Ahad-04/Agriculture-4.0-Seamless-Data-Integration-in-Agricultural-Supply-Chains-ASC-via-IoT-Technologies/NFC/report.docx

Report on NFC-Based Low-Power Sensor Data Reading System

1. Introduction / Background

In our project, we use an MCU (Arduino UNO or Mega) connected with multiple sensors, MQ-2, MQ-4, and DHT22 along with a microSD card module.
The system periodically measures sensor values (every 10 minutes) and stores them in a CSV file on the SD card for data logging and later analysis.

However, continuous wireless transmission using Bluetooth or Wi-Fi modules was found to be power-hungry, making them unsuitable for battery-powered or energy-harvesting systems (like solar or electromagnetic recovery setups).
To achieve ultra-low-power real-time data access, we adopted an NFC-based communication interface using the PN532 NFC Module V3.

This module operates at 13.56 MHz (per ISO/IEC 14443 A/B standards) and supports NFC peer-to-peer, card emulation, and reader modes.
It enables reading of latest sensor values directly from the MCU memory without requiring continuous high-power wireless connectivity.

2. Power Efficiency Motivation

According to the PN532 module datasheet (NXP Semiconductors, 2021):

Parameter | Typical Value | Description / Reference
Operating voltage | 3.3 – 5 V | Compatible with Arduino UNO/Mega logic levels
Operating current (active read mode) | < 100 mA @ 5 V | Active RF field during data transmission
Standby current (RF field on) | 10 µA | Ultra-low standby consumption
Frequency | 13.56 MHz | ISO/IEC 14443 A/B and FeliCa compliant carrier
Communication interface | I²C / SPI / UART | Selectable by DIP switch on V3 board

In comparison:

- Bluetooth (HC-05 / HM-10): 25–40 mA continuous active current
- Wi-Fi (ESP8266 / ESP32): 70–170 mA transmit current peaks
- NFC (PN532): < 100 mA only during tag read, then drops to < 10 µA idle

Hence, NFC reduces average current draw when data access is infrequent (once per few minutes), making it ideal for low-duty-cycle environmental sensor nodes powered by small batteries or energy harvesters.

3. Overview of NFC Technology

3.1 Principle of Operation

Near-Field Communication (NFC) is a short-range (≤ 10 cm) wireless technology standardized under ISO/IEC 18092 and ECMA-340.
It operates at 13.56 MHz, enabling bidirectional data exchange between:

- a Reader/Writer (Initiator)
- and a Tag/Target (Responder).

NFC supports three operation modes:

1. Reader/Writer Mode, Reads/writes passive tags (Type A/B/FeliCa).
2. Peer-to-Peer (P2P) Mode, Two NFC devices exchange data (Active ↔ Passive).
3. Card Emulation Mode, NFC device behaves like a contactless smart card.

Typical data rates: 106 kbps – 424 kbps, with modulation via amplitude-shift keying (ASK).

Reference: PN532 Datasheet

4. PN532 V3 Module – Description and Features

4.1 Hardware Overview

The PN532 V3 module integrates NXP’s PN532 transceiver IC, an RF antenna, and level-shifting logic for Arduino compatibility.
It exposes SPI, I²C, and UART interfaces selectable by onboard DIP switches.

Key specs from the datasheet:

Feature | Description
Chipset | NXP PN532 (ISO/IEC 14443 A/B, 18092)
Frequency | 13.56 MHz ± 7 kHz
Interface | UART / I²C / SPI selectable
Voltage | 3.3 – 5 V tolerant
Current | 60 mA active RF, < 10 µA standby
Range | Up to 5 cm (depends on antenna & field strength)

The module’s onboard DIP switch configures the interface:

- SW1 = ON, SW2 = OFF → UART
- SW1 = OFF, SW2 = ON → I²C
- SW1 = OFF, SW2 = OFF → SPI

5. Implementation for Sensor Data Access

5.1 System Architecture

- Sensors → analog/digital inputs to MCU.
- Arduino logs readings to datalog.csv on the SD card every 10 min.
- PN532 connects via SPI/I²C to the same MCU.
- Smartphone or another NFC device reads the latest value from Arduino memory when tapped.

5.2 Method 1: Using a Single NFC Module and NFC-Enabled Mobile Phone

Concept:
The PN532 operates in Card Emulation Mode (Target mode).
The Arduino continuously updates a small NDEF message containing the latest reading.
When a phone is brought near the module, it reads this message as an NFC tag.

Data Flow:

1. MCU measures sensors and stores readings:
2. Example readings: Temp=27.3°C, Hum=51%, MQ2=143 ppm, MQ4=210 ppm
3. MCU formats this as an NDEF Text record.
4. PN532 stores and advertises the NDEF data in emulation mode.
5. Phone’s NFC reader energizes the field → reads the NDEF payload.
6. Android/iOS automatically shows the message.

Advantages:

- No pairing, no app required.
- Ultra-low power (RF only active during tap).
- Secure short-range (≤ 5 cm).

5.3 Method 2: Two NFC Modules (P2P Communication Between MCUs)

Concept:
Use one PN532 as Initiator (Reader/Controller) and another as Target (Sensor Node).
This leverages the Peer-to-Peer Mode defined by NFCIP-1 (ISO/IEC 18092).

Hardware Setup:

- Node A (Sensor Unit): Arduino + Sensors + PN532 (Target)
- Node B (Receiver Unit): Another MCU + PN532 (Initiator)

Process:

1. Sensor Node periodically prepares the latest readings.
2. When Receiver Node comes near (within 5 cm), it establishes an NFC P2P link.
3. The Initiator requests data using “DEP (Data Exchange Protocol)” frames.
4. The Target sends back formatted sensor readings (text or binary).
5. Receiver displays data on Serial Monitor or LCD.

Advantages:

- Works without smartphones.
- Secure, device-to-device exchange.
- Moderate range (≤ 5 cm).
- Data integrity via CRC16 (per ISO 14443 frame).

5.4 Method 3: Using PN532 as Reader to Poll Passive Tag

In alternate mode, the PN532 acts as a Reader, and a programmable NFC tag (MIFARE Ultralight/NTAG) can store recent readings.
Arduino can update tag memory via I²C at each interval; phone can read tag directly later.
This decouples power domains: the tag remains readable even if MCU is off.

5.5 If Mobile Phone Does Not Support NFC

- Option 1: Use another MCU + PN532 as Initiator (Method 2).
- Option 2: Employ a BLE module (HM-10) temporarily for diagnostics.
- Option 3: Retrieve logs manually via SD card or serial USB connection.

Thus, NFC acts as a primary low-power interface, with BLE/USB serving as fallback for non-NFC devices.

6. Conclusion

The integration of the PN532 V3 NFC module with the sensor-logging MCU system offers a technically efficient and power-optimized solution for real-time data retrieval in portable and autonomous devices.

- NFC’s low activation current and microamp-level standby drastically extend battery life.
- Card Emulation Mode enables instant “tap-to-read” access using any NFC-enabled smartphone.
- Peer-to-Peer Mode provides MCU-to-MCU data transfer without Internet or pairing.
- System remains fully functional even if phones lack NFC support (data available via SD or serial).

This approach aligns with modern low-power IoT design principles, leveraging short-range inductive coupling for minimal-energy, secure, and on-demand communication.
