Ahad-04/Agriculture-4.0-Seamless-Data-Integration-in-Agricultural-Supply-Chains-ASC-via-IoT-Technologies/NFC/UPDATED REPORT.docx

Report on Low-Power Wireless Data Access: NFC vs BLE vs Wi-Fi

1. Background

In this project, an Arduino UNO continuously collects data from multiple environmental sensors:

- MQ-2 (Gas Sensor)
- MQ-4 (Methane Sensor)
- DHT22 (Temperature and Humidity Sensor)

All sensor readings are periodically stored on a microSD card (e.g., every 10 minutes) for local logging and later analysis.
However, for better usability and monitoring, the system also requires a wireless communication interface to transfer sensor readings — either:

- the latest current readings in real-time, or
- Live sending data, to a nearby mobile device or some server.

To evaluate the most power-efficient and practical wireless interface, three technologies were analyzed and compared:

1. NFC Module (PN532), for ultra-low-power, short-range tap-based data transfer.
2. Bluetooth Low Energy Module (HM-10), for moderate-range low-power communication.
3. Wi-Fi (ESP32), for high-speed, long-range data transmission but higher power draw.

2. NFC (PN532) — Working & Power Scenarios

Overview

- Chip: NXP PN532 (ISO/IEC 14443A/B, 18092 compliant (A global standard for contactless smart cards operating at 13.56 MHz)).
- Frequency: 13.56 MHz
- Modes:
  1. Reader/Writer: In this mode, the PN532 acts like a scanner or reader.

It can detect and read data from passive NFC tags (like NTAG213 cards or stickers), or it can write data to them.

⚙️ Example: Arduino updates an NFC tag with the latest sensor readings, and your phone later scans that tag to read them.

  2. Card Emulation (Target): Here, the PN532 itself behaves like a virtual NFC tag or smart card. When a smartphone comes close, the phone reads data directly from the PN532 as if it were reading a tag. ⚙️ Example: Arduino updates the PN532’s internal memory with the latest readings, and your phone “taps” it to instantly get those readings (no tag needed).
  3. Peer-to-Peer (P2P): In this mode, two active NFC devices (for example, two PN532 modules, or a PN532 and a smartphone) communicate directly with each other. ⚙️ Example: One Arduino with sensors acts as the Target, and another device (or phone) acts as the Initiator, exchanging data wirelessly at short range.
- Interfaces: I²C / SPI / UART (selectable via DIP switch)
- Operating Voltage: 2.7 – 5.5 V
- Reference: NXP PN532 Datasheet, Table 1 (Quick Reference Data)

Power Consumption (from PN532 Datasheet)

Parameter | Symbol | Typical | Max | Notes / Reference
Digital logic current | I_DVDD | 25 mA | – | This is the current used by the digital part of the chip, the microcontroller core, logic circuits, communication interfaces (SPI/I²C/UART), etc. It’s always active when the PN532 is “awake.”
Analog circuit current | I_AVDD | 6 mA | – | This is the current used by the analog section, mainly the (Radio Frequency) RF signal processing, filters, and analog front end. It’s active when the NFC field or receiver is working.
Transmitter current | I_TVDD | 60 mA | 150 mA | This is the current drawn when the PN532 is actively transmitting RF power to talk to a tag or phone. The power goes to the antenna (13.56 MHz field). Actual value depends on antenna tuning and distance.
Hard Power Down | I_HPD | 2 µA | – | Ultra-low power mode, almost everything inside the chip is off. Only deep-sleep circuitry remains active. Used when system is idle or powered by battery for long periods.
Soft Power Down | I_SPD | 45 µA | – | Low-power mode where main logic is off but RF detector remains ON. The chip automatically wakes when an external NFC field (like a phone tap) is detected. Very useful for battery-powered systems.

📘 Reference: PN532 Datasheet, Table 1 — “Quick Reference Data”, NXP Semiconductors.

NFC Power Scenarios

Scenario 1 — Always Active (Continuous RF field ON)

• Operation:
The PN532 works as an NFC reader, generating its own 13.56 MHz RF field (a magnetic field used to power and talk with nearby tags).
This field is continuously active so the module can instantly detect any phone or tag that comes close.

• How it behaves:
The internal digital logic draws about 25 mA, the analog front-end about 6 mA, and the RF transmitter adds another 60 mA while maintaining the field.
During real data transfer, current can momentarily rise to around 100–150 mA.

• Current Summary:

- Idle (field ON): ≈ 31 mA
- Active data exchange: ≈ 60–150 mA

Because the RF driver keeps radiating even when no phone is nearby, the module is fully awake all the time.
This gives instant detection, but wastes power continuously, like leaving Wi-Fi permanently ON.

Scenario 2 — Soft Power-Down (RF detector ON)

• Operation:
In this mode, the PN532 turns off its own RF field and most of its internal blocks, but keeps a tiny RF-detect circuit active.
This circuit simply listens for an external 13.56 MHz field (for example, when a smartphone or another reader comes near).
Once that field is sensed, the PN532 wakes up automatically and then activates its main circuits to start communication.

• How it behaves:
When idle, only the low-power detector is active; the rest of the chip sleeps.
On detecting a nearby reader, current jumps temporarily as the chip powers up to exchange data, then drops back again after communication.

• Current Summary:

- Standby (detector ON): ≈ 45 µA
- Wake-up / active exchange: ≈ 60-150 mA
- Return to standby: ≈ 45 µA

This mode offers an excellent balance between readiness and low consumption, the module isn’t radiating energy all the time, but can still respond quickly when a phone or reader approaches.

Scenario 3 — Card Emulation Mode (Passive Target)

• Operation:
In this mode, the PN532 does not generate any RF field itself.
Instead, it behaves like a passive NFC tag or smart card. The smartphone (or another NFC reader) creates the 13.56 MHz magnetic field, which powers the PN532’s antenna coil through inductive coupling, energy is transferred wirelessly from the phone’s field.

• How it behaves:
The MCU (Arduino) periodically sends the latest sensor readings (for example: “Temp = 27 °C, MQ2 = 140 ppm”) to the PN532’s internal buffer.
When a phone is brought close, the PN532 automatically presents these stored readings as an NDEF message (standard NFC data format).
Because the PN532 stays passive until the phone provides energy, it draws almost no current most of the time.
Only a few microamps (µA) are used to keep minimal standby circuitry alive.
During the short instant of communication (a few hundred milliseconds), the phone’s RF field powers the exchange.

• Current Summary:

- Standby (waiting for phone): ≈ 2 µA
- During data exchange (powered by phone field): ≈ 2 – 5 mA approximatley
- After phone removed: returns to ≈ 2 µA

This mode is by far the most power-efficient: the PN532 stays “off” almost all the time and only wakes when a phone touches it, like a smart ID card that comes to life only when tapped, no self-generated RF field, no idle power drain, perfect for ultra-low-power sensor nodes that occasionally need to share data.

NFC Summary

Scenario | PN532 Operating Mode | Approx. Current Draw | Behavior / Description | Power Efficiency
1: Always Active | Reader Mode | ≈ 60 mA typ, 150 mA max | PN532 keeps its 13.56 MHz RF field energized at all times to instantly detect or communicate with a tag or phone. Fast response but drains power continuously. | ❌ Poor (for battery use)
2: Soft Power-Down (RF Detector ON) | Standby Mode with RF Detect | ≈ 45 µA typ | PN532 turns off its RF field but leaves a tiny detector circuit on; wakes automatically when an external NFC field (e.g., phone tap) is sensed. Excellent readiness with minimal draw. | ✅ High
3: Card Emulation (Passive Target) | Target Mode / Passive Tag | ≈ 2 µA standby, 2 – 5 mA during exchange (brief) | PN532 behaves like an NFC tag; powered by the phone’s field during a tap. Arduino writes latest reading to buffer; phone reads it instantly. No self-generated RF field. | ✅ Excellent (lowest power)

Bluetooth (HM-10 BLE Module)

Overview

• Chip: Texas Instruments CC2541 SoC (used inside the HM-10 module).
• Standard: Bluetooth 4.0 BLE (Low Energy).
• Supply Voltage: 2.0 – 3.6 V (typ. 3.3 V) — TI CC2541 Datasheet.
• Typical Range: ~10 m (depends on antenna and environment).
• Interface: UART, default 9600 bps.
• Module Reference: JNHuaMao HM-10 Datasheet v540.

Power Consumption (Verified Datasheet Values)

Mode | Typical Current | Description / Conditions / Reference
Transmit (TX ) | ≈ 18.2 mA | CC2541 operating in TX mode at 0 dBm output power, VDD = 3 V — TI CC2541 Datasheet Rev D, Table 4-6 “RF TX Current”.
Receive (RX) | ≈ 17.9 mA | BLE receiver active, VDD = 3 V — TI CC2541 Datasheet Rev D, Table 4-6 “Receiver Current”.
Advertising / Idle | 1 – 3 mA | HM-10 broadcasting advertising packets; depends on interval (1 s ≈ 1 mA, 100 ms ≈ 3 mA) — HM-10 Datasheet v540 p. 4 “Typical Advertising Current”.
Sleep (Deep Sleep Timer ON) | ≈ 1 µA | Low-power sleep mode with 32 kHz sleep timer active — TI CC2541 Datasheet Section 6.2 “Low Power Modes”.

🔄 BLE Scenarios

🟢 Scenario 1 — Always Connected to Phone

• Arduino sends new readings every 10 minutes while BLE link stays active.
• HM-10 remains in TX/RX state continuously, drawing ≈ 18 mA (0 dBm TX, 17.9 mA RX) — TI CC2541 Table 4-6.
• Provides instant communication but medium battery drain (continuous RF activity).

🟡 Scenario 2 — Periodic Wake-Up Transmission

• Arduino wakes HM-10 every 10 minutes to transmit fresh data, then puts it back to sleep.
• Each cycle: ≈ 18 mA for a few seconds during TX + ≈ 1 µA in sleep — TI CC2541 Sec. 6.2.
• Average consumption is very low, ideal for battery-powered systems that send infrequent updates.

🔵 Scenario 3 — Manual Read on Request

• HM-10 advertises periodically (~1–3 mA depending on interval) — HM-10 v540 p. 4.
• When the user opens the app, phone connects → reads data → disconnects.
• Efficient operation because high current is used only for a few seconds during connection.

📊 BLE Scenario Summary

Scenario | HM-10 State | Approx. Current Draw | Power Behavior / Explanation | Power Efficiency
🟢 1 – Always Connected | TX/RX active link | ≈ 18 mA continuous | Constant RF activity for real-time link with phone. | ⚙️ Medium
🟡 2 – Periodic Wake & Send | Sleep ↔ TX cycle | 18 mA (brief) → 1 µA (sleep) | Short transmit bursts then deep sleep; very low average power. | ✅ High
🔵 3 – Manual Read on Request | Advertising / On-Demand | 1 – 3 mA (advertising) / 18 mA when connected | Idle advertising uses little power; high current only during user connection.

4. Wi-Fi (ESP32 / ESP8266)

⚙️ Technical Overview

- Chip: Espressif ESP32 (dual-core 240 MHz)
- Voltage: 3.0 – 3.6 V
- Range: > 10 m
- Interface: UART / SPI / I²C / Wi-Fi TCP/IP

📘 Reference: Espressif ESP32 Datasheet.

⚡ Power Consumption (Datasheet)

Mode | Current | Description
Transmit (TX) | 160–240 mA | Sending data via Wi-Fi
Receive (RX) | 80–100 mA | Listening for packets
Modem Sleep | 10–20 mA | Wi-Fi off, CPU idle
Deep Sleep | 10 µA | RTC only active

🔄 Wi-Fi Scenarios

🟢 Scenario 1 — Continuous Upload (Always connected)

- Sends readings to server every 10 min or keeps HTTP/MQTT alive.
- ≈ 100–150 mA continuous.
- High drain.

🟡 Scenario 2 — Burst Transmission

- MCU wakes ESP32 every 10 min → connects to Wi-Fi → sends → sleeps.
- Each burst: ~150 mA for ~2–3 s.
- Average still much higher than BLE/NFC.

🔵 Scenario 3 — Manual Access Point Mode

- ESP32 runs hotspot, phone connects & requests latest data.
- RF on during user session (150 mA).
- Idle → ~20 mA.
- Not power-friendly unless externally powered.

5. 💡 Engineering Comparison Summary

Interface | Active Current | Idle Current | Data Range | Needs App? | RF Always ON? | Power Efficiency | Ideal Use
PN532 NFC | 60 mA (burst) | < 10 µA | ≤ 5 cm | ❌ | ❌ | ✅ Excellent | Tap-to-read, ultra-low power nodes
HM-10 BLE | 10–15 mA | 0.5 mA | ≤ 10 m | ✅ | ❌ | ⚙️ Medium | Low-power mobile sync
ESP32 Wi-Fi | 150 mA | 20 mA | ≥ 10 m | ✅ | ✅ | ❌ High | Cloud uploads, local web server

6. 📊 Practical Summary of Real Scenarios

Scenario | Description | RF Field | NFC Power | BLE Power | Wi-Fi Power | Notes
A | Continuous polling (always ready) | ON | ~31 mA | 10 mA | 120 mA | NFC moderate, BLE better
B | Sleep until user taps (NFC soft detect) | OFF | 45 µA | 0.5 mA | 20 mA | NFC best
C | On-demand read (user tap / BLE connect / Wi-Fi hotspot) | ON only when accessed | 60 mA few sec | 10 mA few sec | 150 mA few sec | NFC most efficient
D | Periodic auto-send every 10 min | ON only short burst | 60 mA short | 15 mA short | 150 mA short | NFC still lowest total energy

7. 🔚 Conclusion

✅ NFC (PN532) is the most power-efficient interface when:

- Data is accessed infrequently (e.g., user taps once every few hours).
- Device must stay alive long on small batteries.
- Real-time streaming not needed.

⚙️ BLE (HM-10) offers a balance — suitable for semi-continuous updates or when the user needs remote (~10 m) access.

❌ Wi-Fi (ESP32) is power-hungry — ideal only if high-speed upload or remote IoT cloud access is needed.

🧠 Final Technical Recommendation

For your Arduino + MQ2 + MQ4 + DHT22 setup:

- Use PN532 in Card Emulation Mode.
- Arduino writes the latest reading as NDEF text.
- When a phone taps, it reads instantly.
- RF stays off most of the time → only microamp consumption.

If you ever want a mobile app view without NFC, add BLE (HM-10) as optional.

📚 References

1. NXP PN532 Datasheet, Table 1 “Quick Reference Data.”
2. Elechouse PN532 Manual, Rev. 3.2, Section 6.3 (Power and Interface).
3. TI CC2541 (HM-10) Datasheet, Table 4.3 (Operating Conditions).
4. Espressif ESP32 Datasheet, Sections 6.3 & 6.5 (Power Consumption).
5. ISO/IEC 14443A/B, ISO/IEC 18092 NFC Standards.

Would you like me to make this report into a formatted Word (DOCX) or PDF version for printing/submission (with tables and diagrams)?
