Ahad-04/Agriculture-4.0-Seamless-Data-Integration-in-Agricultural-Supply-Chains-ASC-via-IoT-Technologies/Fruit decay project/BLE/BLE_Reciver_server/readme.docx

This code acts as a wireless bridge. It connects to Mega via Bluetooth (BLE) to receive sensor data, and connects WiFi to forward that data to a Flask server on PC.

It handles both "live" instant readings and big "bulk" history dumps (CSV files) without having to wire anything up.

Code Nature:

The Middleman:

It doesn’t save data itself. Its whole job is to take data from BLE and push it to HTTP (WiFi) as fast and reliably as possible.

Reliability System (ACKs):

Bluetooth can sometimes lose packets. This code uses a custom "handshake":

- When it receives a good data frame from the Mega, it checks it for errors (CRC).
- If it's good, it sends a tiny "ACK" (acknowledgment) message back to the Mega so the Mega knows it doesn't need to re-send it.

Web Triggers:

You control it by opening web pages on its IP address:

- Visiting http://[ESP-IP]/pull_all tells it to ask the Mega for everything (full history).
- Visiting http://[ESP-IP]/pull_fast tells it to ask for just the latest data.

Main Functions

Maintains Two Connections:

- WiFi: Stays connected to "ChipVista 2.4G" to talk to your PC.
- BLE: Actively scans for and auto-connects to the Mega.

Handles Incoming BLE Data:

- Live Data: If it gets a small, 28-byte packet, it knows it's a live reading. It converts it to JSON and POSTs it to your Flask server's /pong endpoint.
- CSV History: If it gets other data, it treats it as part of a file dump and POSTs it to /csv_chunk.
- Transfer Complete: When the Mega sends an empty frame, this code hits /csv_done to tell your server the file is finished.

Serial Monitor shows:

- [WiFi] IP: ... (IP address of esp32 paste it into app.py)
- [BLE] connected / disconnected
- [HTTP JSON] 200 (Confirming data reached your PC server)
- [ACK] seq=... sent (Showing it's confirming data to the Mega)

Componenet | BLE | NFC
MCU TX (Arduino mega) | Price with link | -
MCU TX (arduno nano) | - | Price with link
MCU RX (ESP32) | PRICE WITH LINK | -
MCU RX (NANO ) | - | PRICE WITH LINK
