Ahad-04/Agriculture-4.0-Seamless-Data-Integration-in-Agricultural-Supply-Chains-ASC-via-IoT-Technologies/Fruit decay project/BLE/BLE_transmission/readme.docx

This code turns Mega into a smart, reliable, field data logger. It gathers data from sensors (mq2, mq4, pressure sensor, DHT22), saves it permanently to an SD card, and then sends it to your ESP32 bridge using a robust, error-checking Bluetooth link.

Code Nature:

The Data Source: This is the main brain. It reads all the sensors

Reliable Sender: This code doesn't just Serial.print data over Bluetooth and hope it arrives. It uses a custom protocol:

1. It wraps every piece of data (live or from the CSV) in a special "frame" with a sequence number and an error-check (CRC).
2. It sends the frame and then waits for the ESP32 to send back an "ACK" (acknowledgment) with the same sequence number.
3. If it doesn't get the ACK, it assumes the packet was lost and re-sends it up to 5 times. This makes the data transfer very robust.

On-Demand History: It doesn't constantly stream the old data. It waits patiently until the ESP32 sends it a command:

- "REQ": "Send me everything from the beginning."
- "FAST": "Just send me the last 2KB of data." (For latest 15 readings)

Main Functions

- Sampling (Every SAMPLE_INTERVAL_MS):
  - Reads MQ2 (Ethylene), MQ4 (Methane), DHT22, and BMP280 sensors.
  - Converts sensor values into PPM and standard units.
- Data Logging (Dual-Mode):
  - CSV Log: Appends a new, human-readable line to datalog.csv on the SD card for easy analysis in Excel.
- Live Data Push:
  - Sends every new SAMPLE_INTERVAL_MS, sample to the ESP32 using the reliable frame system (which the ESP32 then posts to your server's /pong endpoint).
- CSV History Dump:
  - When it gets a "REQ" or "FAST" command, it opens datalog.csv.
  - It reads the file (either from the start or just the end) in small, 20-byte chunks.
  - It sends each chunk using the reliable frame system (which the ESP32 posts to /csv_chunk).
  - When the file is done, it sends a special "END" frame so the ESP32 knows the transfer is complete.

Serial Monitor shows:

- [DATA] ts=... mq2_ppm=... (Shows you the full sensor reading)
- [CSV] appended (Confirms data was saved to the SD card)
- [BLE] REQ → stream ALL datalog.csv (Tells you when a history dump starts)
- [BLE] send failed → abort CSV stream (Warns you if the BLE connection drops during a transfer)
