Ahad-04/Agriculture-4.0-Seamless-Data-Integration-in-Agricultural-Supply-Chains-ASC-via-IoT-Technologies/Fruit decay project/NFC/NFC_READER/Readme.docx

Overview

This code runs on an Arduino nano (with OLED + PN532) and acts as an NFC tag viewer.
When you bring an pasive tag card (the one that was written by NFC transmitter) near the reader, it:

- reads the fixed slots (start date/time, current date/time, start MQ2/MQ4, current MQ2/MQ4),
- reads all the daily snapshot blocks (1D=..., 2D=...),
- shows the main lines on the OLED,
- and prints a clean, combined summary on the Serial Monitor.

Code Nature

- It keeps watching for an NFC tag.
- When a new tag is detected, it checks if it’s found then read it.
- If some blocks fail to read on the first try, it retries on the same tag (without asking you to remove it).
- If the tag is removed (not seen for 10 seconds), it goes back to “No Tag Present”.

What it reads

From (Blocks)slots 1..6 it expects things like:

- SD:YYYY-MM-DD → start date
- ST:HH:MM:SS → start time
- ND:YYYY-MM-DD → current date
- NT:HH:MM:SS → current time
- Sm2=xxx Sm4=yyy → start gas values
- Mq2=xxx Mq4=yyy → current gas values

After that, it reads slot 7 onward which contain daily lines like:
1D=16327,2461
and it even parses them into friendly format like:
1Dm2=16327 1Dm4=2461

Serial Monitor Shows

When a tag is read, Serial prints:

- tag UID
- each block content (HEX + ASCII)
- final compact line like: [TAG] start=SD ST | now=ND NT | Smq2=... Smq4=... | MQ2=... | MQ4=... | 1Dm2=... 1Dm4=... | 2Dm2=...

So you can see exactly what the Transmission side wrote.

OLED Display Shows

- While idle: “NFC Ready / Waiting for tag”
- Shows main data only (start date, start time, current date, current time, Starting gas values, current gas values)
- On error: “Read Failed / Check Key”
- On tag removal: “No Tag Present”

Retry Logic

If the tag was detected but one block didn’t read (maybe weak coupling), it doesn’t make you remove the tag, it keeps the same UID and retries a few times (up to 8) with a small delay. This was to fix your earlier issue “it waits 10s even if some blocks failed”.
