Ahad-04/Agriculture-4.0-Seamless-Data-Integration-in-Agricultural-Supply-Chains-ASC-via-IoT-Technologies/Fruit decay project/NFC/NFC_Transmission_side/readme.docx

This code reads gas sensors (MQ2, MQ4) and environment sensors (DHT22) every (SAMPLE_INTERVAL_MS), saves readings to an SD card, and when you bring an NFC tag, it writes all important info (start date, current date, Start mq2 mq4 values, Current mq2 mq4 values, daily gas levels) onto the tag.
It also keeps track of days passed and stores one gas snapshot per day in EEPROM so nothing is lost after reset.

Code Nature:

Time Handling:

- When the board first starts, it needs to know the current time.
  1. MCU waits for you to send time manually from Serial like: TIME=2025-11-06 20:15:00
  2. If you don’t provide anything, it just uses the compile time of the code.
- After setting time, you can tell it when your experiment “starts” using the command: SET → This makes start time = current time and clears old day records so it can begin a fresh new logging cycle. If your experiment starts by uploading latest code then dont need for this
- Later, if you ever want to change the starting time again:
  3. Send new time with TIME=TIME=YYYY-MM-DD HH:MM:SS
  4. Then send SET again → this resets everything and restarts from that new moment.

Main Functions

1. Reads sensors every (SAMPLE_INTERVAL_MS): MQ2 & MQ4 → PPM values DHT22 → temperature & humidity
2. Logs data to SD card: Saves all readings with timestamps to datalog.csv.
3. Saves daily averages: Every time a new day starts, one MQ2/MQ4 snapshot is saved into EEPROM.
4. Writes to NFC tag: When you tap a tag, it writes:
  - Start date/time
  - Current date/time
  - Start gas values
  - Current gas values
  - Daily readings from EEPROM
5. Serial Monitor shows:
  - [SAMPLE] start=... | now=... | MQ2=... | MQ4=... | temp=... | hum=...
  - [SD] APPENDED or FAIL
  - [NFC] Ready: ... when tag can be written
6. You can control it via Serial:
  - TIME=YYYY-MM-DD HH:MM:SS → Set current time
  - SET → Start new experiment (sets start = now)
  - TIME? → Show current and start times
