Ahad-04/Agriculture-4.0-Seamless-Data-Integration-in-Agricultural-Supply-Chains-ASC-via-IoT-Technologies/Round 1 readings/exp2,3/EXP_123/MQ4_EXP_2.png

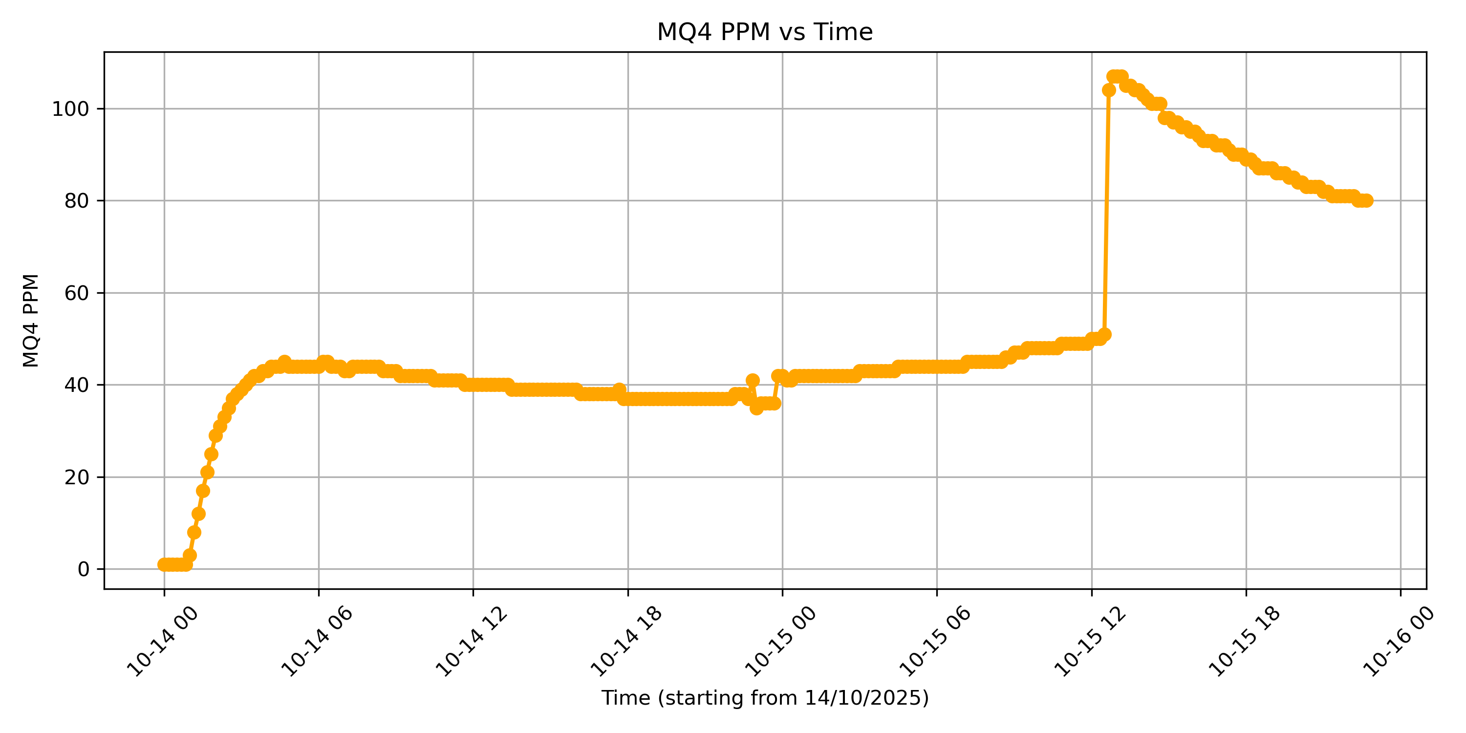
Round 1 readings/exp2,3/EXP_123/MQ4_EXP_2.png
