Ahad-04/Agriculture-4.0-Seamless-Data-Integration-in-Agricultural-Supply-Chains-ASC-via-IoT-Technologies/Round 1 readings/graph/Day3_MQ2.png

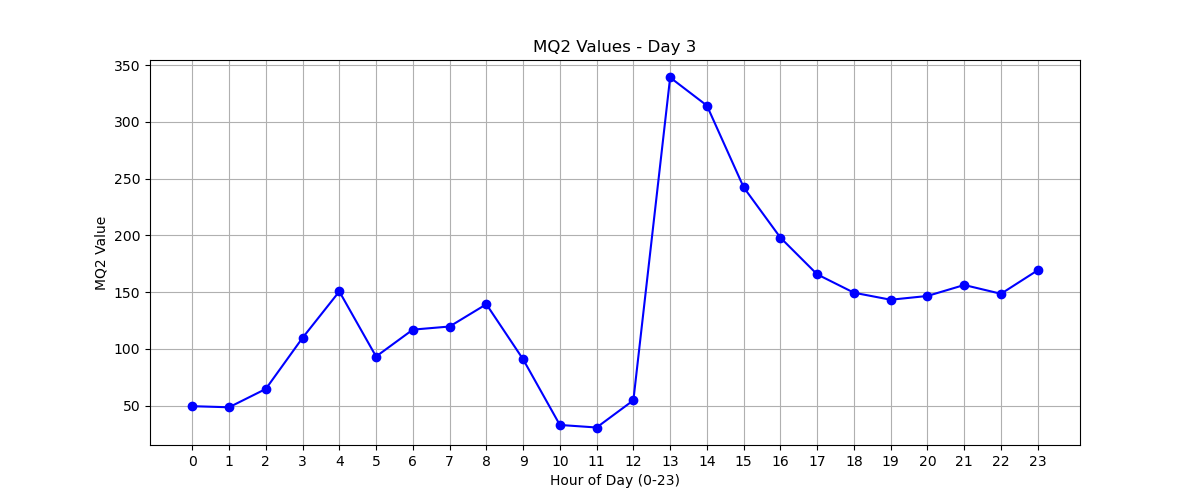
Round 1 readings/graph/Day3_MQ2.png
