Ahad-04/Agriculture-4.0-Seamless-Data-Integration-in-Agricultural-Supply-Chains-ASC-via-IoT-Technologies/Round 1 readings/new graph/Day1_MQ4.png

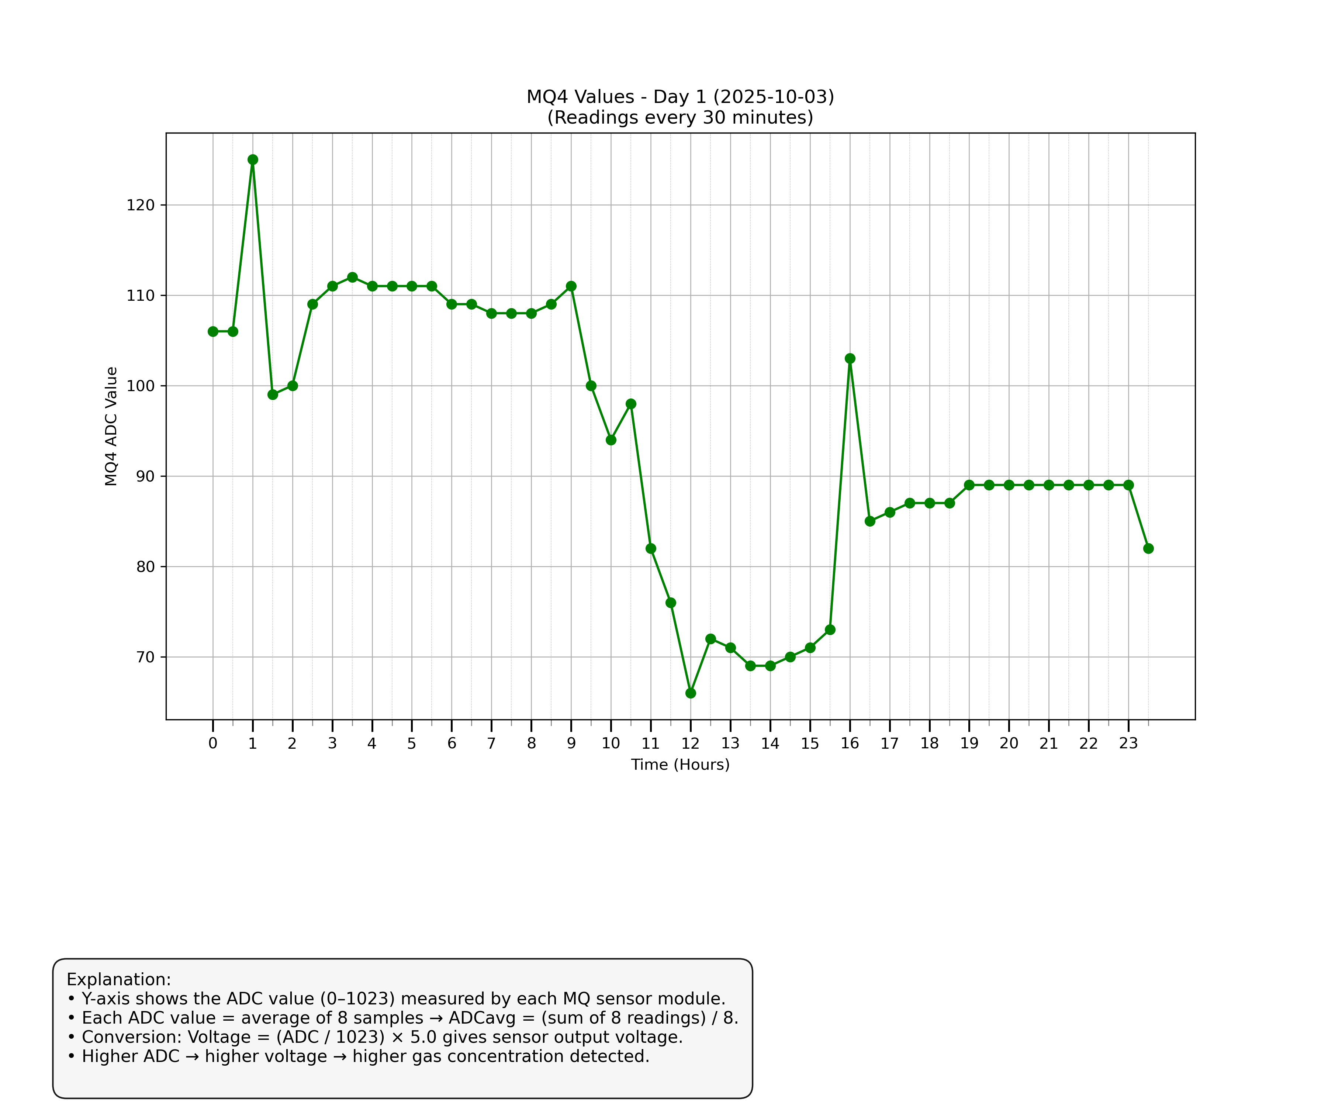
Round 1 readings/new graph/Day1_MQ4.png
