Ahad-04/Agriculture-4.0-Seamless-Data-Integration-in-Agricultural-Supply-Chains-ASC-via-IoT-Technologies/Round 1 readings/overall/Overall_MQ4_ppm.png

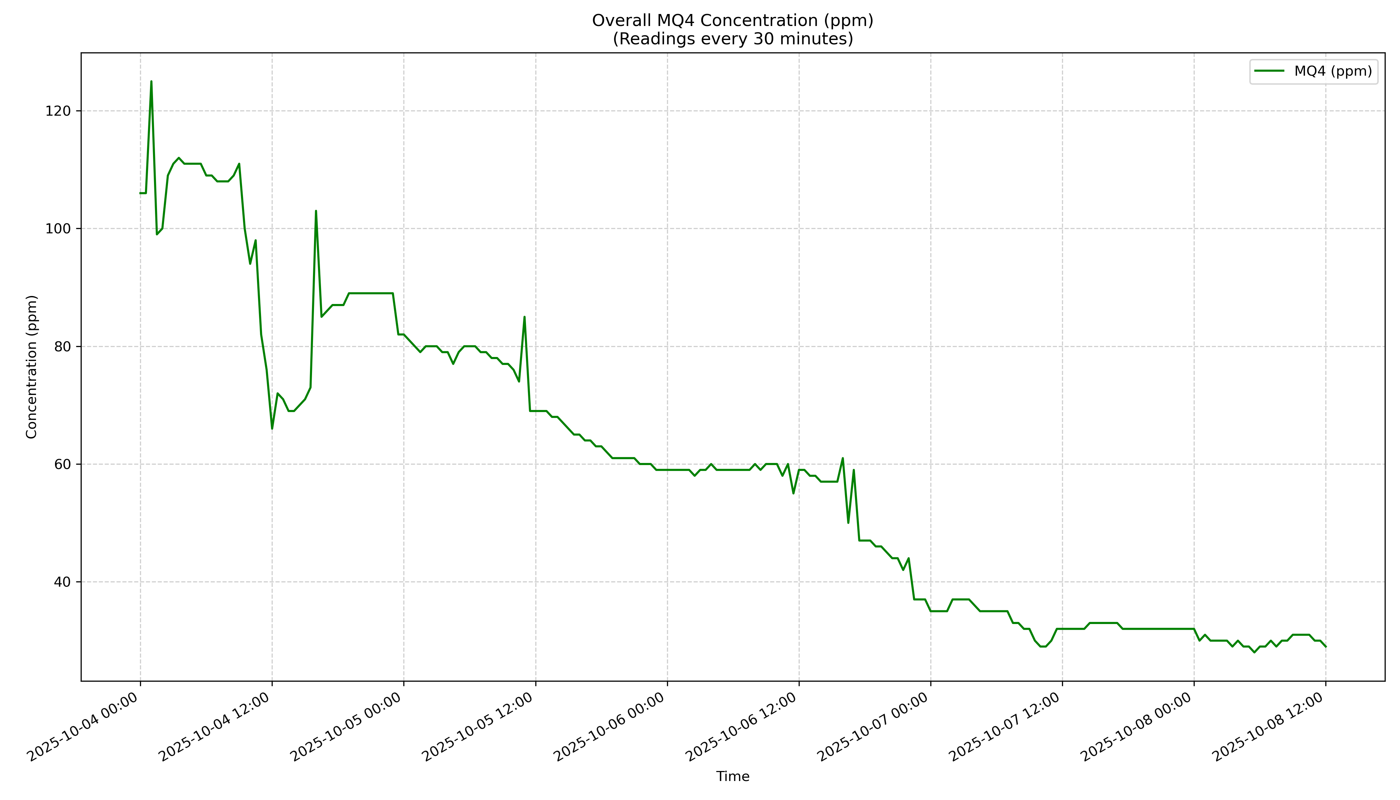
Round 1 readings/overall/Overall_MQ4_ppm.png
