Ahad-04/Agriculture-4.0-Seamless-Data-Integration-in-Agricultural-Supply-Chains-ASC-via-IoT-Technologies/Round 2 readings/MQ2_EXP2.png

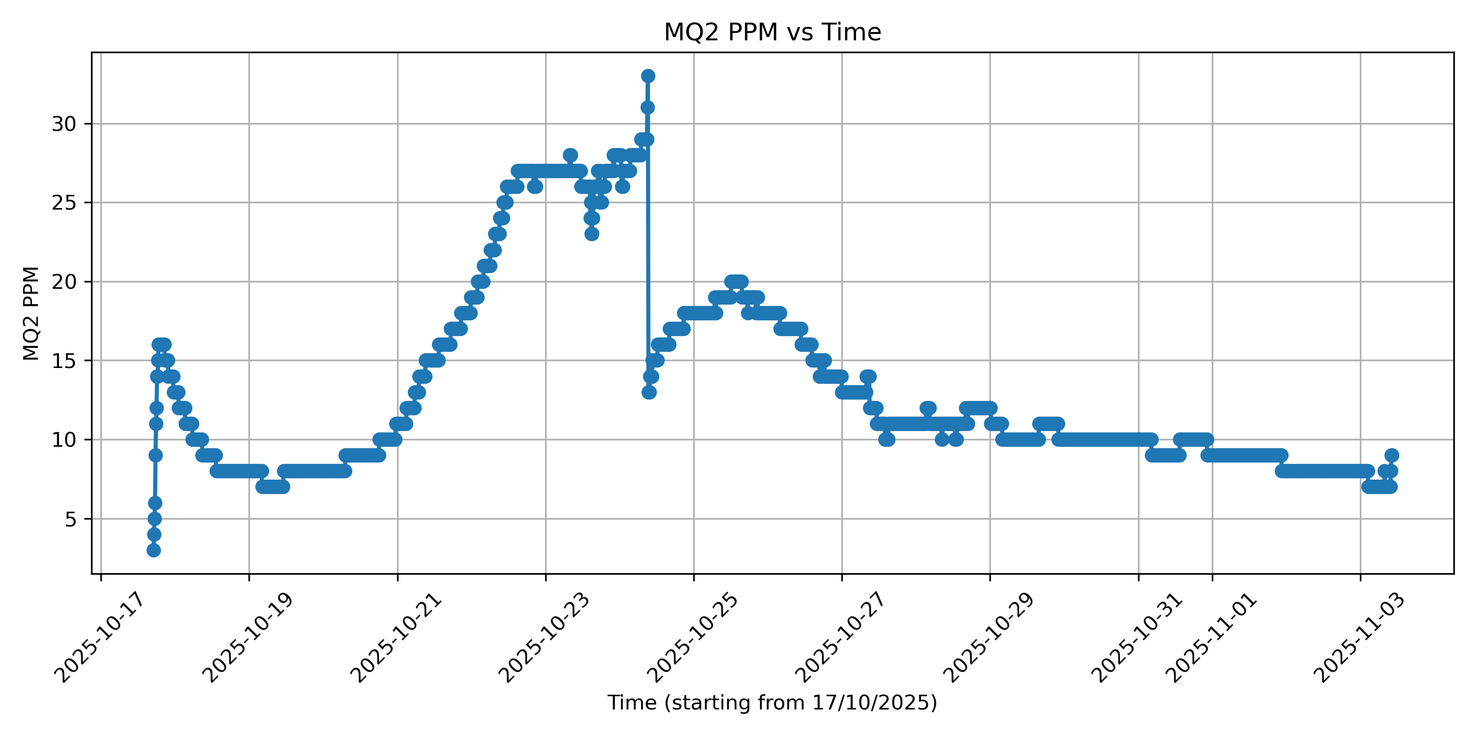
Round 2 readings/MQ2_EXP2.png
