Ahad-04/Agriculture-4.0-Seamless-Data-Integration-in-Agricultural-Supply-Chains-ASC-via-IoT-Technologies/Round 2 readings/MQ4_EXP1.png

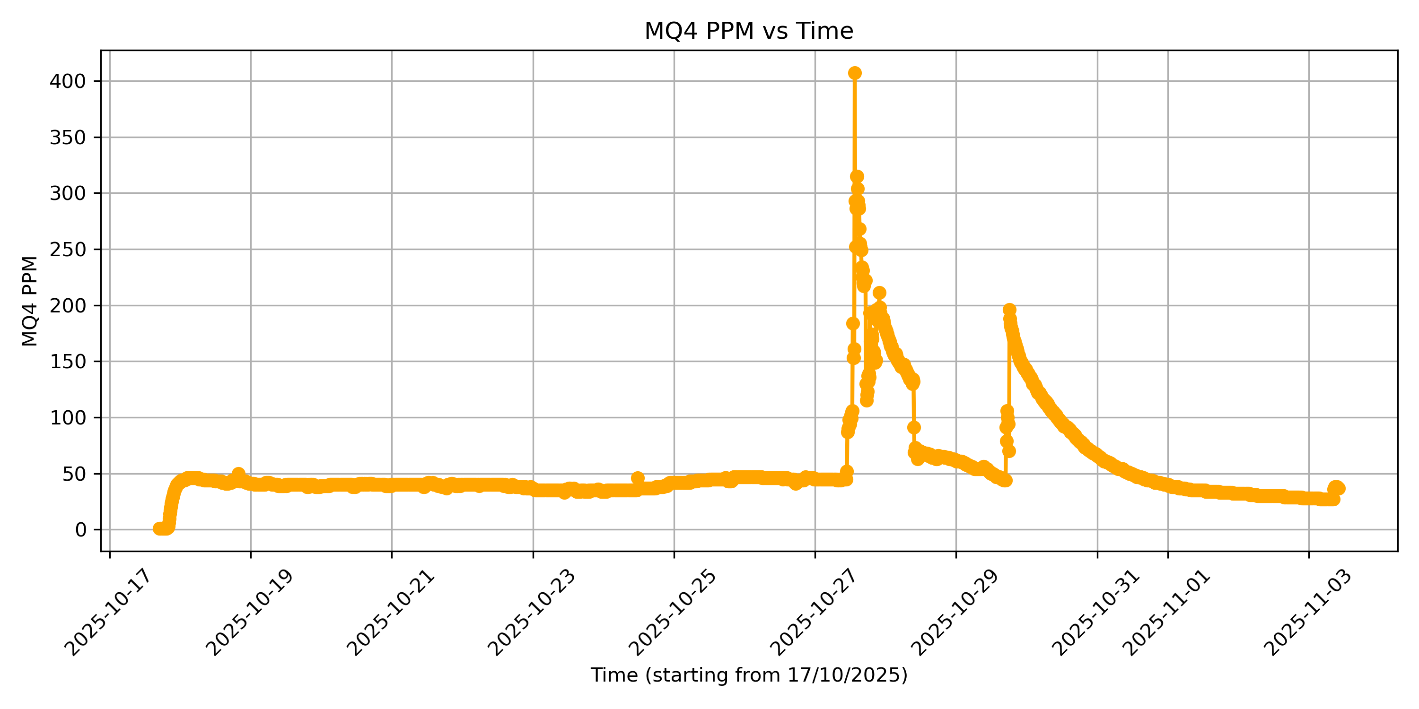
Round 2 readings/MQ4_EXP1.png
