Ahad-04/Agriculture-4.0-Seamless-Data-Integration-in-Agricultural-Supply-Chains-ASC-via-IoT-Technologies/Round 2_partial readings/MQ4_EXP1,2.png

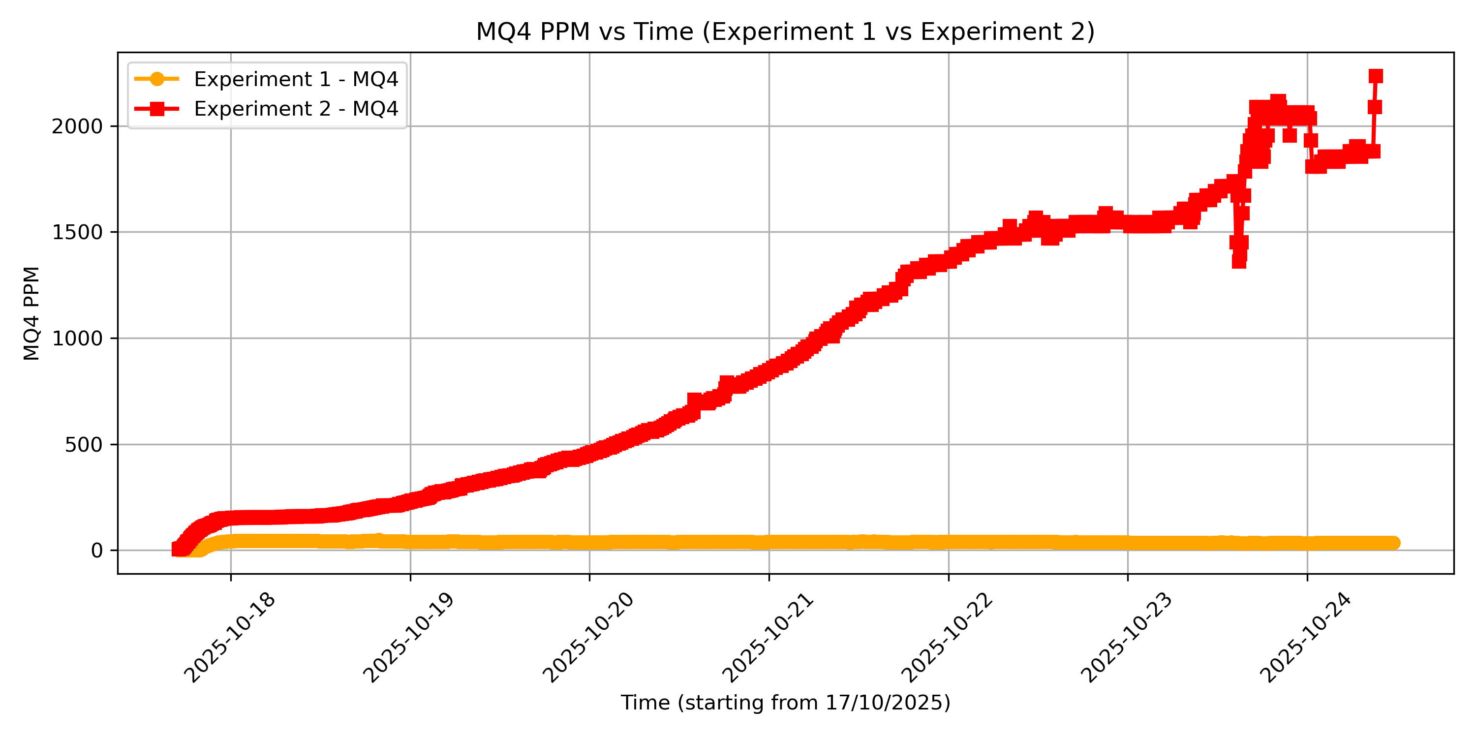
Round 2_partial readings/MQ4_EXP1,2.png
